Gonnie2219/AI-Anti-Theft-System-CAV/firmware/AntiTheftSystemLilygo.ino

/*
 * Anti-Theft System  -  LILYGO T-SIM7600G-H Cellular Gateway
 *
 * Receives ALERT and STATUS messages from the Main ESP32 over UART2 and
 * POSTs notifications + photo evidence to ntfy.sh for the dashboard.
 * Receives owner commands via MQTT push (with Worker-queue poll as
 * fallback) and forwards them to Main over UART.
 *
 * SIM:  Hologram (AT&T/T-Mobile multi-carrier),  APN "hologram"
 *
 * Network notes:
 *   Hologram assigns IPv4 PDP addresses. We use the modem's built-in
 *   HTTP client (AT+HTTPINIT / AT+HTTPACTION) for ntfy.sh communication.
 *   Owner commands arrive via MQTT push (HiveMQ Cloud, AT+CMQTT) with
 *   HTTPS polling of the Cloudflare Worker command queue as fallback.
 *
 * UART map:
 *   Serial   (UART0)  =  USB debug
 *   Serial1  (UART1)  =  SIM7600 modem (TX=27, RX=26)
 *   Serial2  (UART2)  =  Main ESP32     (TX=19, RX=21)
 */

#include <Arduino.h>
#include <HardwareSerial.h>
#include <Preferences.h>
#include "secrets.h"

// ── Pins ─────────────────────────────────────────────────────
#define MODEM_TX        27
#define MODEM_RX        26
#define MODEM_PWRKEY     4
#define MODEM_FLIGHT    25
#define LED_PIN         12
#define MAIN_RX         21
#define MAIN_TX         19

// ── Configuration ────────────────────────────────────────────
const char    APN[]            = "hologram";
const char    NTFY_TOPIC[]     = "antitheft-gonnie-2219";

#define IMG_BUF_SIZE        65536      // 64 KB photo buffer
#define HEARTBEAT_MS      300000UL     // 5 minutes
#define GPS_UPDATE_MS     300000UL     // 5 minutes
#define WORKER_CMD_POLL_URL "https://antitheft-whatsapp-bridge.gonnie2219.workers.dev/commands/poll"
// Adaptive command-poll cadence: fast while armed or recently active,
// slow when idle — each poll costs a full TLS handshake (~5 KB) on
// pay-per-MB cellular, so idle polling is the dominant data cost.
#define CMD_POLL_FAST_MS      5000UL   // armed OR recent activity
#define CMD_POLL_SLOW_MS     30000UL   // idle
#define POLL_ACTIVE_WINDOW_MS 600000UL // 10 min "recent activity" window
#define WORKER_INGEST_URL  "https://antitheft-whatsapp-bridge.gonnie2219.workers.dev/ingest"

// Keep the modem HTTP(S) service initialized across requests instead of
// HTTPTERM after every one — avoids a full TCP+TLS handshake (~5 KB, 2-4 s)
// per request. Session is termed + re-inited only on error/timeout (one
// retry) or when the URL scheme flips between http (ntfy) and https (Worker).
#define USE_PERSISTENT_HTTP 1

// Shared secret for authenticating with Worker endpoints.
// See secrets.h.example — copy to secrets.h and fill in the real value.
#include "secrets.h"

// ── Aliases ──────────────────────────────────────────────────
#define SerialMon  Serial
#define SerialAT   Serial1
HardwareSerial SerialMain(2);

// ── Globals ──────────────────────────────────────────────────
uint8_t*      imgBuffer     = nullptr;
size_t        imgSize       = 0;
bool          networkReady  = false;
bool          systemArmed   = false;
bool          gpsOn         = false;
String        gpsLat, gpsLon, gpsMapsLink;
unsigned long lastHeartbeat = 0;
unsigned long lastGPS       = 0;

// GPS speed (parsed from +CGPSINFO field 8)
float gpsSpeedKnots = 0.0;
float gpsSpeedMph   = -1.0;  // -1 = no fix / unknown
float gpsSpeedKmh   = 0.0;

// Motion state from Main ESP32
String motionState = "UNKNOWN";
float  accelDelta  = 0.0;
float  gyroMag     = 0.0;
unsigned long lastMotionUpdateMs = 0;

// Status push timing
unsigned long lastStatusPushMs = 0;

// Alarm in progress (synchronous — guards status push from firing during handleAlert)
bool alarmInProgress = false;

// Command polling (Worker KV queue)
Preferences   preferences;
String        lastCmdId;
unsigned long lastCmdPoll   = 0;

// Adaptive poll state — fast within POLL_ACTIVE_WINDOW_MS of boot, last
// received command, last ALERT, or last STATUS change; also while armed.
unsigned long lastActivityMs = 0;
bool          pollFast       = true;

// MQTT URC intercept + connection layer.
String atBuffer;                     // persistent serial accumulator
String mqttPendingCmd;               // single-slot command queue
volatile bool mqttConnected = false;
unsigned long lastMqttReconnectMs = 0;
const unsigned long MQTT_RECONNECT_INTERVAL_MS = 10000;  // 10s backoff
static const char* MQTT_CMD_TOPIC = "cmd/antitheft/commands";

// ─────────────────────────────────────────────────────────────
//  Centralized SerialAT reader — intercepts MQTT URCs
// ─────────────────────────────────────────────────────────────
// Reads all available bytes from SerialAT.  Any MQTT RX block or
// +CMQTTCONNLOST URCs are extracted and handled; everything else
// is appended to the global `atBuffer` for the caller to consume.
// When no MQTT URCs are present this is byte-for-byte equivalent
// to the old `while (SerialAT.available()) acc += (char)SerialAT.read()`.
//
// Partial-URC safety: if a +CMQTTRXSTART is detected but +CMQTTRXEND
// has not yet arrived, everything from the marker onward is held
// back in atBuffer.  Only the bytes BEFORE the marker are returned
// to the caller, so HTTP pattern-matchers never see URC fragments.
void drainSerialAT() {
  while (SerialAT.available()) atBuffer += (char)SerialAT.read();

  // ── Cap atBuffer to prevent unbounded growth / heap fragmentation ──
  int bufLen = atBuffer.length();
  if (bufLen > 16384) {
    Serial.println("[MQTT] RX buffer overflow, dropped");
    atBuffer = "";
    return;
  }
  if (bufLen > 8192 && atBuffer.indexOf("+CMQTTRXSTART:") < 0) {
    atBuffer = "";
    return;
  }

  // ── Multi-line MQTT RX block ──────────────────────────────
  //
  // +CMQTTRXSTART: <client>,<topic_total_len>,<payload_total_len>\r\n
  // +CMQTTRXTOPIC: <client>,<sub_len>\r\n<topic_bytes>\r\n
  //   (may repeat; sub-lengths sum to topic_total_len)
  // +CMQTTRXPAYLOAD: <client>,<sub_len>\r\n<payload_bytes>\r\n
  //   (may repeat; sub-lengths sum to payload_total_len)
  // +CMQTTRXEND: <client>\r\n
  int rxIdx = atBuffer.indexOf("+CMQTTRXSTART:");
  if (rxIdx >= 0) {
    int endIdx = atBuffer.indexOf("+CMQTTRXEND:", rxIdx);
    if (endIdx < 0) {
      // Block incomplete — hold back from rxIdx onward
      atBuffer = atBuffer.substring(0, rxIdx);
      return;
    }
    // Require a PAYLOAD marker between START and END (splice safety)
    int payCheck = atBuffer.indexOf("+CMQTTRXPAYLOAD:", rxIdx);
    if (payCheck < 0 || payCheck >= endIdx) {
      // False match (binary collision) — hold back
      atBuffer = atBuffer.substring(0, rxIdx);
      return;
    }
    // Bound end-line: \n must be within 32 chars of endIdx
    int endLineEnd = atBuffer.indexOf('\n', endIdx);
    if (endLineEnd < 0 || endLineEnd - endIdx > 32) {
      atBuffer = atBuffer.substring(0, rxIdx);
      return;
    }
    endLineEnd++;  // consume the \n

    // Extract the full block for parsing
    String block = atBuffer.substring(rxIdx, endLineEnd);

    // Parse payload by concatenating all +CMQTTRXPAYLOAD chunks
    String payload;
    int searchFrom = 0;
    while (true) {
      int pIdx = block.indexOf("+CMQTTRXPAYLOAD:", searchFrom);
      if (pIdx < 0) break;
      int comma = block.indexOf(',', pIdx + 16);  // skip "+CMQTTRXPAYLOAD:"
      if (comma < 0) break;
      int nlAfterHdr = block.indexOf('\n', comma);
      if (nlAfterHdr < 0) break;
      int subLen = block.substring(comma + 1, nlAfterHdr).toInt();
      int dataStart = nlAfterHdr + 1;  // first byte after \n
      if (dataStart + subLen <= (int)block.length()) {
        payload += block.substring(dataStart, dataStart + subLen);
      }
      searchFrom = dataStart + subLen;
    }

    // Trim trailing \r, \n, and space from assembled payload
    String cleaned = payload;
    while (cleaned.length() > 0) {
      char last = cleaned.charAt(cleaned.length() - 1);
      if (last == '\r' || last == '\n' || last == ' ') cleaned = cleaned.substring(0, cleaned.length() - 1);
      else break;
    }

    mqttPendingCmd = cleaned;

    // Splice the entire block out of atBuffer
    atBuffer = atBuffer.substring(0, rxIdx) + atBuffer.substring(endLineEnd);
    return;
  }

  // ── +CMQTTCONNLOST: <client>,<cause>\r\n ──
  int lostIdx = atBuffer.indexOf("+CMQTTCONNLOST:");
  if (lostIdx >= 0) {
    int lostEnd = atBuffer.indexOf('\n', lostIdx);
    if (lostEnd < 0 || lostEnd - lostIdx > 32) {
      // Line incomplete or false match — hold back
      atBuffer = atBuffer.substring(0, lostIdx);
      return;
    }
    // Full line received — flag disconnect, splice out
    mqttConnected = false;
    lostEnd++;  // consume the \n
    atBuffer = atBuffer.substring(0, lostIdx) + atBuffer.substring(lostEnd);
  }
}

// ─────────────────────────────────────────────────────────────
//  MQTT connect — bring up HiveMQ Cloud via AT+CMQTT*
// ─────────────────────────────────────────────────────────────
// Non-blocking in the sense that it returns cleanly on any
// failure (no halt, no retry loop).  Caller retries via loop().
void connectMQTT() {
  SerialMon.println("[MQTT] === Connecting ===");

  // Defensive teardown — clear stale MQTT state from prior run
  sendAT("AT+CMQTTDISC=0,60", "OK", 5000);
  delay(200); while (SerialAT.available()) SerialAT.read();
  sendAT("AT+CMQTTSTOP", "OK", 3000);
  delay(500); while (SerialAT.available()) SerialAT.read();

  // Start MQTT service
  String r = sendAT("AT+CMQTTSTART", "OK", 5000);
  if (r.indexOf("OK") < 0) {
    SerialMon.println("[MQTT] CMQTTSTART failed: " + r);
    return;
  }

  // Acquire client 0 in SSL mode
  r = sendAT("AT+CMQTTACCQ=0,\"antitheft-lilygo\",1", "OK", 5000);
  if (r.indexOf("OK") < 0) {
    SerialMon.println("[MQTT] CMQTTACCQ failed: " + r);
    sendAT("AT+CMQTTSTOP", "OK", 3000);
    return;
  }

  // Bind to SSL context 0 (already configured in setup)
  r = sendAT("AT+CMQTTSSLCFG=0,0", "OK", 3000);
  if (r.indexOf("OK") < 0) {
    SerialMon.println("[MQTT] CMQTTSSLCFG failed: " + r);
    sendAT("AT+CMQTTREL=0", "OK", 3000);
    sendAT("AT+CMQTTSTOP", "OK", 3000);
    return;
  }

  // Pre-connect check: abort if an alert is pending — don't block the loop
  if (alarmInProgress || SerialMain.available()) {
    SerialMon.println("[MQTT] connect aborted (alert pending)");
    sendAT("AT+CMQTTREL=0", "OK", 3000);
    sendAT("AT+CMQTTSTOP", "OK", 3000);
    return;
  }

  // Connect to broker (8s timeout — keeps worst-case loop stall bounded)
  String connectCmd = "AT+CMQTTCONNECT=0,\"tcp://"
    + String(MQTT_HOST) + ":" + String(MQTT_PORT)
    + "\",60,1,\"" + String(MQTT_USER) + "\",\"" + String(MQTT_PASS) + "\"";
  r = sendAT(connectCmd, "+CMQTTCONNECT: 0,0", 8000);
  if (r.indexOf("+CMQTTCONNECT: 0,0") < 0) {
    SerialMon.println("[MQTT] CONNECT failed: " + r);
    sendAT("AT+CMQTTREL=0", "OK", 3000);
    sendAT("AT+CMQTTSTOP", "OK", 3000);
    return;
  }

  // Subscribe — Form A: AT+CMQTTSUB=0,<len>,1  then > prompt then topic bytes
  int tlen = strlen(MQTT_CMD_TOPIC);
  drainSerialAT(); atBuffer = "";
  SerialAT.print("AT+CMQTTSUB=0,");
  SerialAT.print(tlen);
  SerialAT.print(",1\r\n");

  // Wait for > prompt
  unsigned long t0 = millis();
  bool gotPrompt = false;
  while (millis() - t0 < 5000) {
    while (SerialAT.available()) {
      if (SerialAT.read() == '>') { gotPrompt = true; break; }
    }
    if (gotPrompt) break;
    delay(5);
  }
  if (!gotPrompt) {
    SerialMon.println("[MQTT] SUB no > prompt");
    sendAT("AT+CMQTTDISC=0,60", "OK", 5000);
    sendAT("AT+CMQTTREL=0", "OK", 3000);
    sendAT("AT+CMQTTSTOP", "OK", 3000);
    return;
  }

  // Send topic bytes — NO trailing CRLF
  SerialAT.write((const uint8_t*)MQTT_CMD_TOPIC, tlen);

  // Wait for +CMQTTSUB: 0,0
  String subResp;
  t0 = millis();
  while (millis() - t0 < 10000) {
    while (SerialAT.available()) subResp += (char)SerialAT.read();
    if (subResp.indexOf("+CMQTTSUB: 0,0") >= 0) break;
    delay(10);
  }
  if (subResp.indexOf("+CMQTTSUB: 0,0") < 0) {
    SerialMon.println("[MQTT] SUB failed: " + subResp);
    sendAT("AT+CMQTTDISC=0,60", "OK", 5000);
    sendAT("AT+CMQTTREL=0", "OK", 3000);
    sendAT("AT+CMQTTSTOP", "OK", 3000);
    return;
  }

  // Drain any leftover before returning to normal operation
  delay(200);
  while (SerialAT.available()) SerialAT.read();
  atBuffer = "";

  mqttConnected = true;
  SerialMon.println("[MQTT] Connected + subscribed to " + String(MQTT_CMD_TOPIC));
}

// ─────────────────────────────────────────────────────────────
//  Consume pending MQTT commands (max 3 per call to avoid starving loop)
// ─────────────────────────────────────────────────────────────
void consumeMqttCommand() {
  for (int i = 0; i < 3; i++) {
    if (mqttPendingCmd.length() == 0) return;
    String cmd = mqttPendingCmd;
    mqttPendingCmd = "";  // clear immediately to prevent double-process
    SerialMon.println("[MQTT] dispatch: " + cmd);
    lastActivityMs = millis();  // MQTT command = activity (triggers fast poll)
    handleSMSCommand(cmd);
    // Re-drain in case another URC arrived during handleSMSCommand
    drainSerialAT();
  }
}

// ─────────────────────────────────────────────────────────────
//  AT command helper
// ─────────────────────────────────────────────────────────────
String sendAT(String cmd, String expect, unsigned long timeout) {
  drainSerialAT(); atBuffer = "";     // discard stale data (preserves MQTT intercept)
  SerialAT.println(cmd);
  unsigned long start = millis();
  String resp;
  while (millis() - start < timeout) {
    drainSerialAT(); resp += atBuffer; atBuffer = "";
    if (resp.indexOf(expect) >= 0) break;
    delay(10);
  }
  return resp;
}

// ─────────────────────────────────────────────────────────────
//  Network watchdog — verify registration before HTTP traffic
// ─────────────────────────────────────────────────────────────
// AT+CREG? is a local modem query (no data cost). If registration was
// lost (parking garage, tower handoff), re-attach before the request.
// Called from httpInit(), the single chokepoint for ALL outbound HTTP
// (ntfy posts and Worker poll/ingest alike).
bool ensureNetwork() {
  String r = sendAT("AT+CREG?", "OK", 2000);
  if (r.indexOf(",1") >= 0 || r.indexOf(",5") >= 0) {
    if (!networkReady) {
      networkReady = true;
      SerialMon.println("NETWORK: recovered");
    }
    return true;
  }

  SerialMon.println("[NET] not registered - re-attaching...");
  networkReady = false;
  sendAT("AT+CFUN=1", "OK", 15000);   // no-op if already full-function
  for (int i = 0; i < 10; i++) {
    delay(2000);
    r = sendAT("AT+CREG?", "OK", 2000);
    if (r.indexOf(",1") >= 0 || r.indexOf(",5") >= 0) {
      sendAT("AT+CGATT=1", "OK", 10000);   // packet-switched attach
      sendAT("AT+CGACT=1,1", "OK", 10000); // re-activate PDP context
      networkReady = true;
      SerialMon.println("NETWORK: recovered");
      return true;
    }
  }
  SerialMon.println("[NET] re-attach failed");
  return false;
}

// ─────────────────────────────────────────────────────────────
//  HTTP client  (uses SIM7600 built-in HTTPINIT subsystem)
// ─────────────────────────────────────────────────────────────
//
// The HTTPINIT subsystem is a separate network stack from NETOPEN/
// CIPOPEN. With USE_PERSISTENT_HTTP the service stays initialized across
// requests: HTTPINIT once -> per request HTTPPARA (URL/content/headers) ->
// HTTPDATA -> HTTPACTION -> wait URC. HTTPTERM only runs on error/timeout
// (each request function retries once through a fresh init) or when the
// URL scheme flips http<->https (AT+HTTPSSL must be set before HTTPINIT).
// Note: HTTPPARA values (USERDATA etc.) persist within a session — every
// caller sets its own headers, so stale values are always overwritten.
//
// ntfy.sh requests use HTTP (no TLS). The Worker endpoints (/ingest,
// /commands/poll) use HTTPS — the SSL stack is configured once in
// setup() via AT+CSSLCFG, and httpInit() toggles AT+HTTPSSL per URL.
// Alert content and GPS coordinates sent to ntfy are cleartext.
// Accepted trade-off — the ntfy topic name provides obscurity.

// Persistent session state
static bool httpSessionOpen = false;
static bool httpSessionSsl  = false;

static void httpTerm() {
  sendAT("AT+HTTPTERM", "OK", 1000);
  httpSessionOpen = false;
}

static int waitHttpAction(unsigned long timeout) {
  unsigned long start = millis();
  String acc;
  while (millis() - start < timeout) {
    drainSerialAT(); acc += atBuffer; atBuffer = "";
    int idx = acc.indexOf("+HTTPACTION:");
    if (idx >= 0) {
      int eol = acc.indexOf('\n', idx);
      if (eol > idx) {
        // Format:  +HTTPACTION: <method>,<status>,<datalen>
        String urc = acc.substring(idx, eol);
        int c1 = urc.indexOf(',');
        int c2 = urc.indexOf(',', c1 + 1);
        if (c1 > 0 && c2 > c1) {
          return urc.substring(c1 + 1, c2).toInt();
        }
      }
    }
    delay(20);
  }
  return -1;
}

static bool waitDownloadPrompt(unsigned long timeout) {
  unsigned long start = millis();
  String r;
  while (millis() - start < timeout) {
    drainSerialAT(); r += atBuffer; atBuffer = "";
    if (r.indexOf("DOWNLOAD") >= 0) return true;
    if (r.indexOf("ERROR") >= 0) return false;
    delay(10);
  }
  return false;
}

static bool waitOK(unsigned long timeout) {
  unsigned long start = millis();
  String r;
  while (millis() - start < timeout) {
    drainSerialAT(); r += atBuffer; atBuffer = "";
    if (r.indexOf("OK") >= 0) return true;
    if (r.indexOf("ERROR") >= 0) return false;
    delay(10);
  }
  return false;
}

static bool httpInit(String url, String contentType, String headers) {
  bool wasReady = networkReady;
  if (!ensureNetwork()) {
    if (httpSessionOpen) httpTerm();
    return false;
  }
  // Network was re-attached — any kept-alive session is dead.
  if (!wasReady && httpSessionOpen) httpTerm();

  bool wantSsl = url.startsWith("https");

#if USE_PERSISTENT_HTTP
  // Reuse the open session when the SSL mode matches; AT+HTTPSSL must be
  // set before HTTPINIT, so an http<->https switch forces a fresh init.
  if (httpSessionOpen && wantSsl != httpSessionSsl) httpTerm();

  if (!httpSessionOpen) {
    sendAT("AT+HTTPTERM", "OK", 1000);  // clear any stray service
    while (SerialAT.available()) SerialAT.read();
    sendAT("AT+HTTPSSL=" + String(wantSsl ? 1 : 0), "OK", 2000);
    String initResp = sendAT("AT+HTTPINIT", "OK", 5000);
    if (initResp.indexOf("OK") < 0) {
      SerialMon.println("[HTTP] HTTPINIT failed. Modem said: " + initResp);
      return false;
    }
    httpSessionOpen = true;
    httpSessionSsl  = wantSsl;
  } else {
    while (SerialAT.available()) SerialAT.read();
  }
#else
  if (sendAT("AT+HTTPTERM", "OK", 1000).indexOf("OK") >= 0) {
    // ok, was active, now closed
  }
  while (SerialAT.available()) SerialAT.read();

  // Toggle SSL based on URL scheme
  sendAT("AT+HTTPSSL=" + String(wantSsl ? 1 : 0), "OK", 2000);

  String initResp = sendAT("AT+HTTPINIT", "OK", 5000);
  if (initResp.indexOf("OK") < 0) {
    SerialMon.println("[HTTP] HTTPINIT failed. Modem said: " + initResp);
    return false;
  }
#endif

  sendAT("AT+HTTPPARA=\"URL\",\"" + url + "\"", "OK", 3000);
  sendAT("AT+HTTPPARA=\"CONNECTTO\",30", "OK", 2000);
  sendAT("AT+HTTPPARA=\"RECVTO\",30", "OK", 2000);
  sendAT("AT+HTTPPARA=\"CONTENT\",\"" + contentType + "\"", "OK", 3000);
  if (headers.length() > 0) {
    String esc = headers;
    esc.replace("\"", "\\\"");
    sendAT("AT+HTTPPARA=\"USERDATA\",\"" + esc + "\"", "OK", 3000);
  }
  return true;
}

// Returns HTTP status code (200 = success) or -1 for TCP/connection failure.
// One stale-session retry: a kept-alive session can die server-side; the
// first failure terms the session and the second attempt re-inits it.
int httpPostText(String topic, String headers, String body) {
  SerialMon.println("[HTTP] POST /" + topic + "  (" + String(body.length()) + " bytes)");
  unsigned long t0 = millis();
  int status = -1;

  for (int attempt = 0; attempt < 2 && status < 0; attempt++) {
    if (attempt > 0) SerialMon.println("[HTTP] session reset, retrying");
    if (!httpInit("http://ntfy.sh/" + topic, "text/plain", headers)) { httpTerm(); continue; }

    SerialAT.print("AT+HTTPDATA=");
    SerialAT.print(body.length());
    SerialAT.println(",10000");
    if (!waitDownloadPrompt(3000)) { httpTerm(); continue; }
    SerialAT.print(body);
    if (!waitOK(15000))            { httpTerm(); continue; }

    sendAT("AT+HTTPACTION=1", "OK", 3000);
    status = waitHttpAction(60000);
    if (status < 0) httpTerm();
  }

#if !USE_PERSISTENT_HTTP
  httpTerm();
#endif
  unsigned long ms = millis() - t0;
  if (status < 0)         SerialMon.println("[HTTP] TCP fail (" + String(ms) + " ms)");
  else if (status == 200) SerialMon.println("[HTTP] OK (" + String(ms) + " ms)");
  else                    SerialMon.println("[HTTP] HTTP " + String(status) + " (" + String(ms) + " ms)");
  return status;
}

// Returns HTTP status code (200 = success) or -1 for TCP/connection failure.
int httpPostBinary(String topic, String headers, const uint8_t* data, size_t len) {
  SerialMon.println("[HTTP] POST /" + topic + "  (" + String(len) + " binary bytes)");
  if (len > 100000) { SerialMon.println("[HTTP] body too large"); return -1; }
  unsigned long t0 = millis();
  int status = -1;

  for (int attempt = 0; attempt < 2 && status < 0; attempt++) {
    if (attempt > 0) SerialMon.println("[HTTP] session reset, retrying");
    if (!httpInit("http://ntfy.sh/" + topic, "application/octet-stream", headers)) { httpTerm(); continue; }

    SerialAT.print("AT+HTTPDATA=");
    SerialAT.print(len);
    SerialAT.println(",60000");
    if (!waitDownloadPrompt(3000)) { httpTerm(); continue; }

    size_t sent = 0;
    while (sent < len) {
      size_t chunk = (len - sent > 1024) ? 1024 : (len - sent);
      SerialAT.write(data + sent, chunk);
      sent += chunk;
      delay(10);
    }
    if (!waitOK(30000)) { httpTerm(); continue; }

    sendAT("AT+HTTPACTION=1", "OK", 3000);
    status = waitHttpAction(120000);
    if (status < 0) httpTerm();
  }

#if !USE_PERSISTENT_HTTP
  httpTerm();
#endif
  unsigned long ms = millis() - t0;
  if (status < 0)         SerialMon.println("[HTTP] TCP fail (" + String(ms) + " ms)");
  else if (status == 200) SerialMon.println("[HTTP] OK (" + String(ms) + " ms)");
  else                    SerialMon.println("[HTTP] HTTP " + String(status) + " (" + String(ms) + " ms)");
  return status;
}

// ─────────────────────────────────────────────────────────────
//  Retry wrappers — exponential backoff, skip retry on 4xx
// ─────────────────────────────────────────────────────────────
bool httpPostTextRetry(String topic, String headers, String body) {
  for (int attempt = 0; attempt < 3; attempt++) {
    if (attempt > 0) {
      unsigned long backoff = 2000UL << (attempt - 1);  // 2s, 4s
      SerialMon.println("[HTTP] retry " + String(attempt) + "/2 in " + String(backoff) + "ms");
      delay(backoff);
    }
    int rc = httpPostText(topic, headers, body);
    if (rc == 200) return true;
    if (rc >= 400 && rc < 500) {
      SerialMon.println("[HTTP] 4xx client error, not retrying");
      return false;
    }
  }
  return false;
}

bool httpPostBinaryRetry(String topic, String headers, const uint8_t* data, size_t len) {
  for (int attempt = 0; attempt < 3; attempt++) {
    if (attempt > 0) {
      unsigned long backoff = 2000UL << (attempt - 1);
      SerialMon.println("[HTTP] retry " + String(attempt) + "/2 in " + String(backoff) + "ms");
      delay(backoff);
    }
    int rc = httpPostBinary(topic, headers, data, len);
    if (rc == 200) return true;
    if (rc >= 400 && rc < 500) {
      SerialMon.println("[HTTP] 4xx client error, not retrying");
      return false;
    }
  }
  return false;
}

// ─────────────────────────────────────────────────────────────
//  Direct POST to arbitrary URL (for Worker /ingest fast path)
// ─────────────────────────────────────────────────────────────
int httpPostDirect(const char* url, String body) {
  SerialMon.println("[INGEST] POST (" + String(body.length()) + " bytes)");
  String authHeader = "X-CMD-Secret: " + String(CMD_SECRET);
  unsigned long t0 = millis();
  int status = -1;

  for (int attempt = 0; attempt < 2 && status < 0; attempt++) {
    if (attempt > 0) SerialMon.println("[HTTP] session reset, retrying");
    if (!httpInit(String(url), "text/plain", authHeader)) { httpTerm(); continue; }

    SerialAT.print("AT+HTTPDATA=");
    SerialAT.print(body.length());
    SerialAT.println(",10000");
    if (!waitDownloadPrompt(3000)) { httpTerm(); continue; }
    SerialAT.print(body);
    if (!waitOK(15000))            { httpTerm(); continue; }

    sendAT("AT+HTTPACTION=1", "OK", 3000);
    status = waitHttpAction(30000);
    if (status < 0) httpTerm();
  }

#if !USE_PERSISTENT_HTTP
  httpTerm();
#endif
  unsigned long ms = millis() - t0;
  if (status == 200) SerialMon.println("[INGEST] OK (" + String(ms) + " ms)");
  else               SerialMon.println("[INGEST] failed: " + String(status) + " (" + String(ms) + " ms)");
  return status;
}

// ─────────────────────────────────────────────────────────────
//  JSON helper (no library — simple field extraction)
// ─────────────────────────────────────────────────────────────
String extractJsonString(const String& json, const String& field) {
  String key = "\"" + field + "\":\"";
  int start = json.indexOf(key);
  if (start < 0) return "";
  start += key.length();
  int end = json.indexOf('"', start);
  if (end < 0) return "";
  return json.substring(start, end);
}

// [LAT] Extract a bare numeric JSON value (no quotes), e.g. "readTs":1749...
String extractJsonNumber(const String& json, const String& field) {
  String key = "\"" + field + "\":";
  int start = json.indexOf(key);
  if (start < 0) return "";
  start += key.length();
  // Skip whitespace
  while (start < (int)json.length() && json.charAt(start) == ' ') start++;
  int end = start;
  while (end < (int)json.length() && json.charAt(end) >= '0' && json.charAt(end) <= '9') end++;
  if (end == start) return "";
  return json.substring(start, end);
}

// ─────────────────────────────────────────────────────────────
//  HTTP read body (for GET responses)
// ─────────────────────────────────────────────────────────────
String httpReadBody(int maxLen) {
  String cmd = "AT+HTTPREAD=0," + String(maxLen);
  drainSerialAT(); atBuffer = "";     // discard stale data (preserves MQTT intercept)
  SerialAT.println(cmd);

  unsigned long start = millis();
  String acc;
  while (millis() - start < 10000) {
    drainSerialAT(); acc += atBuffer; atBuffer = "";
    if (acc.indexOf("OK") >= 0 || acc.indexOf("ERROR") >= 0) break;
    delay(20);
  }

  // Parse: +HTTPREAD: <len>\r\n<body>\r\nOK
  int idx = acc.indexOf("+HTTPREAD:");
  if (idx < 0) return "";
  int nl = acc.indexOf('\n', idx);
  if (nl < 0) return "";
  int okIdx = acc.indexOf("\r\nOK", nl);
  if (okIdx < 0) okIdx = acc.indexOf("\nOK", nl);
  if (okIdx < 0) return acc.substring(nl + 1);
  return acc.substring(nl + 1, okIdx);
}

// ─────────────────────────────────────────────────────────────
//  Command polling (SMS / Dashboard → Worker KV queue → here)
// ─────────────────────────────────────────────────────────────
void pollWorkerCommands() {
  // On first boot (lastCmdId=="0"), any commands in the queue are
  // stale leftovers. Skip them and just advance the cursor.
  bool skipExecution = (lastCmdId == "0");
  if (skipExecution) {
    SerialMon.println("[CMD] first boot — seeding cursor");
  }

  String url = String(WORKER_CMD_POLL_URL) + "?since=" + lastCmdId;

  String authHeader = "Authorization: Bearer " + String(DEVICE_POLL_TOKEN);
  unsigned long t0 = millis();
  int status = -1;

  // Force fresh session — persistent reuse causes edge 400 on stale socket
  httpTerm();

  for (int attempt = 0; attempt < 2 && status < 0; attempt++) {
    if (attempt > 0) SerialMon.println("[HTTP] session reset, retrying");
    if (!httpInit(url, "", authHeader)) { httpTerm(); continue; }
    sendAT("AT+HTTPACTION=0", "OK", 3000);  // GET
    status = waitHttpAction(15000);
    if (status < 0) httpTerm();
  }

  if (status != 200) {
#if !USE_PERSISTENT_HTTP
    httpTerm();
#endif
    if (status > 0) SerialMon.println("[CMD] poll HTTP " + String(status));
    return;
  }

  String body = httpReadBody(4096);
#if !USE_PERSISTENT_HTTP
  httpTerm();
#endif
  SerialMon.println("[HTTP] GET poll OK (" + String(millis() - t0) + " ms)");

  if (body.length() == 0) return;

  // Extract latestId (top-level string field in JSON response)
  String newLatestId = extractJsonString(body, "latestId");
  // [LAT] Extract top-level readTs for latency measurement
  String readTsStr = extractJsonNumber(body, "readTs");

  // Parse commands array — find each "command":"VALUE" in the response.
  // Worker returns: {"commands":[{"id":"...","command":"STATUS"},...],"latestId":"..."}
  bool hadCommands = false;
  int searchPos = 0;
  while (true) {
    int cmdStart = body.indexOf("\"command\":\"", searchPos);
    if (cmdStart < 0) break;
    cmdStart += 11;  // skip past "command":"
    int cmdEnd = body.indexOf('"', cmdStart);
    if (cmdEnd < 0) break;

    String cmd = body.substring(cmdStart, cmdEnd);
    cmd.trim();
    cmd.toUpperCase();
    hadCommands = true;

    // [LAT] Extract per-command writeTs and log latency metrics
    {
      // Search forward from cmdStart — writeTs follows "command" in the JSON object
      int wtSearch = body.indexOf("\"writeTs\":", cmdStart);
      String writeTsStr = "";
      if (wtSearch >= 0) writeTsStr = extractJsonNumber(body.substring(wtSearch), "writeTs");
      unsigned long httpMs = millis() - t0;
      String pollWaitMs = "";
      if (writeTsStr.length() > 0 && readTsStr.length() > 0) {
        // Both are epoch-ms strings — subtract as doubles to avoid 32-bit overflow
        double wt = 0, rt = 0;
        for (int i = 0; i < (int)writeTsStr.length(); i++) wt = wt * 10 + (writeTsStr.charAt(i) - '0');
        for (int i = 0; i < (int)readTsStr.length(); i++) rt = rt * 10 + (readTsStr.charAt(i) - '0');
        pollWaitMs = String((long)(rt - wt));
      }
      SerialMon.println("[LAT] cmd=" + cmd +
                         " writeTs=" + writeTsStr +
                         " readTs=" + readTsStr +
                         " pollWaitMs=" + pollWaitMs +
                         " httpMs=" + String(httpMs));
    }

    if (skipExecution) {
      SerialMon.println("[CMD] skipped (first boot): " + cmd);
    } else {
      SerialMon.println("[CMD] worker: " + cmd);
      handleSMSCommand(cmd);
    }

    searchPos = cmdEnd + 1;
  }

  if (hadCommands) lastActivityMs = millis();  // user activity → stay on fast poll

  // Advance cursor — only persist to NVS when commands were actually
  // received.  The Worker returns Date.now() as latestId even for empty
  // queues, which would cause a flash write every poll cycle (every 5s).
  if (newLatestId.length() > 0) {
    lastCmdId = newLatestId;
    if (hadCommands) {
      preferences.putString("lastCmdId", lastCmdId);
    }
  }
}

// ─────────────────────────────────────────────────────────────
//  GPS
// ─────────────────────────────────────────────────────────────
void updateGPS() {
  if (!gpsOn) return;  // GPS engine off; keep last-known lat/lon
  String r = sendAT("AT+CGPSINFO", "OK", 2000);
  SerialMon.println("[GPS] raw: " + r);
  int idx = r.indexOf("+CGPSINFO:");
  if (idx < 0) {
    gpsSpeedMph = -1.0;
    SerialMain.println("GPS_SPEED:" + String(gpsSpeedMph, 1));
    return;
  }
  String info = r.substring(idx + 11);
  info.trim();
  if (info.length() < 10 || info.charAt(0) == ',') {
    gpsSpeedMph = -1.0;
    SerialMain.println("GPS_SPEED:" + String(gpsSpeedMph, 1));
    return;
  }

  int c1 = info.indexOf(',');
  int c2 = info.indexOf(',', c1 + 1);
  int c3 = info.indexOf(',', c2 + 1);
  int c4 = info.indexOf(',', c3 + 1);
  if (c4 < 0) {
    gpsSpeedMph = -1.0;
    SerialMain.println("GPS_SPEED:" + String(gpsSpeedMph, 1));
    return;
  }

  float lat = info.substring(0, 2).toFloat() + info.substring(2, c1).toFloat() / 60.0;
  if (info.substring(c1 + 1, c2) == "S") lat = -lat;
  float lon = info.substring(c2 + 1, c2 + 4).toFloat() + info.substring(c2 + 4, c3).toFloat() / 60.0;
  if (info.substring(c3 + 1, c4) == "W") lon = -lon;

  gpsLat = String(lat, 6);
  gpsLon = String(lon, 6);
  gpsMapsLink = "https://maps.google.com/?q=" + gpsLat + "," + gpsLon;

  // Parse speed (field 7 = speed in knots)
  // +CGPSINFO: <lat>,<N/S>,<lon>,<E/W>,<date>,<UTC>,<alt>,<speed_knots>,<course>
  int c5 = info.indexOf(',', c4 + 1);
  int c6 = (c5 >= 0) ? info.indexOf(',', c5 + 1) : -1;
  int c7 = (c6 >= 0) ? info.indexOf(',', c6 + 1) : -1;
  if (c7 >= 0) {
    int c8 = info.indexOf(',', c7 + 1);
    String speedStr = (c8 >= 0) ? info.substring(c7 + 1, c8) : info.substring(c7 + 1);
    speedStr.trim();
    gpsSpeedKnots = (speedStr.length() > 0) ? speedStr.toFloat() : 0.0;
    gpsSpeedMph = gpsSpeedKnots * 1.15078;
    gpsSpeedKmh = gpsSpeedKnots * 1.852;
  } else {
    gpsSpeedKnots = 0.0;
    gpsSpeedMph = 0.0;
    gpsSpeedKmh = 0.0;
  }

  SerialMon.println("[GPS] speed: " + String(gpsSpeedKnots, 2) + " kn / " +
                    String(gpsSpeedMph, 1) + " mph / " + String(gpsSpeedKmh, 1) + " km/h");
  SerialMain.println("GPS_SPEED:" + String(gpsSpeedMph, 1));
}

// ─────────────────────────────────────────────────────────────
//  Battery (AT+CBC — local query, no data cost)
// ─────────────────────────────────────────────────────────────
// SIM7600 replies "+CBC: 3.912V". Older SIMCom firmwares reply
// "+CBC: <charging>,<percent>,<millivolts>". Handle both, and estimate
// percent from voltage when the modem doesn't report one
// (Li-ion: 3.40 V = 0 %, 4.20 V = 100 %, linear).
String getBatteryStatus() {
  String r = sendAT("AT+CBC", "OK", 2000);
  int i = r.indexOf("+CBC:");
  if (i < 0) return "";
  int eol = r.indexOf('\n', i);
  String line = (eol > i) ? r.substring(i + 5, eol) : r.substring(i + 5);
  line.trim();

  float volts = -1.0;
  int   pct   = -1;
  int c1 = line.indexOf(',');
  if (c1 >= 0) {
    int c2 = line.indexOf(',', c1 + 1);
    pct = line.substring(c1 + 1, (c2 > 0) ? c2 : (int)line.length()).toInt();
    if (c2 > 0) volts = line.substring(c2 + 1).toFloat() / 1000.0;
  } else {
    line.replace("V", "");
    volts = line.toFloat();
  }

  if (pct < 0 && volts > 0) {
    pct = (int)((volts - 3.40) / 0.80 * 100.0);
    if (pct < 0)   pct = 0;
    if (pct > 100) pct = 100;
  }
  if (pct < 0 && volts <= 0) return "";

  String s = "Battery: " + String(pct) + "%";
  if (volts > 0) s += " (" + String(volts, 2) + "V)";
  return s;
}

String getModemTime() {
  String r = sendAT("AT+CCLK?", "OK", 2000);
  int i = r.indexOf("+CCLK: \"");
  if (i < 0) return "";
  int j = r.indexOf("\"", i + 8);
  if (j <= i) return "";
  return r.substring(i + 8, j);
}

// ─────────────────────────────────────────────────────────────
//  SMS — inbound
// ─────────────────────────────────────────────────────────────
void handleSMSCommand(String cmd) {
  cmd.trim();
  cmd.toUpperCase();
  SerialMon.println("[CMD] " + cmd);

  if (cmd == "ARM") {
    SerialMon.println("[LAT] uart_relay cmd=ARM t=" + String(millis()));
    SerialMain.println("SMS_CMD:ARM");
  } else if (cmd == "DISARM") {
    SerialMon.println("[LAT] uart_relay cmd=DISARM t=" + String(millis()));
    SerialMain.println("SMS_CMD:DISARM");
  } else if (cmd == "STATUS") {
    SerialMon.println("[LAT] uart_relay cmd=STATUS t=" + String(millis()));
    SerialMain.println("SMS_CMD:STATUS");
  } else if (cmd == "PHOTO") {
    SerialMon.println("[LAT] uart_relay cmd=PHOTO t=" + String(millis()));
    SerialMain.println("SMS_CMD:PHOTO");
  } else if (cmd == "IMMOBILIZE") {
    SerialMon.println("[LAT] uart_relay cmd=IMMOBILIZE t=" + String(millis()));
    SerialMain.println("SMS_CMD:IMMOBILIZE");
  } else if (cmd == "RESTORE") {
    SerialMon.println("[LAT] uart_relay cmd=RESTORE t=" + String(millis()));
    SerialMain.println("SMS_CMD:RESTORE");
  } else if (cmd == "GPS") {
    updateGPS();
    String gpsReply = gpsLat.length() > 0
      ? ("SMS_REPLY: GPS: " + gpsLat + "," + gpsLon + " " + gpsMapsLink)
      : "SMS_REPLY: GPS: no fix";
    httpPostText(NTFY_TOPIC, "Title: Command Reply\r\nPriority: default\r\nTags: speech_balloon", gpsReply);
  } else if (cmd == "HELP") {
    httpPostText(NTFY_TOPIC, "Title: Command Reply\r\nPriority: default\r\nTags: speech_balloon",
                 "SMS_REPLY: Commands: ARM DISARM STATUS PHOTO GPS IMMOBILIZE RESTORE HELP");
  }
  // Unknown commands silently dropped (Worker already validated)
}

// ─────────────────────────────────────────────────────────────
//  Photo reception from Main ESP32
// ─────────────────────────────────────────────────────────────
bool receiveImage() {
  imgSize = 0;
  unsigned long timeout = millis() + 30000;

  while (millis() < timeout) {
    if (!SerialMain.available()) { delay(10); continue; }

    String line = SerialMain.readStringUntil('\n');
    line.trim();
    if (line == "NOIMG") return false;
    if (!line.startsWith("IMG:")) continue;

    size_t expected = line.substring(4).toInt();
    if (expected == 0 || expected > IMG_BUF_SIZE || !imgBuffer) return false;

    SerialMon.println("[IMG] expecting " + String(expected) + " bytes");
    unsigned long byteTimeout = millis() + 20000;
    while (imgSize < expected && millis() < byteTimeout) {
      size_t avail = SerialMain.available();
      if (avail > 0) {
        size_t toRead = expected - imgSize;
        if (avail < toRead) toRead = avail;
        SerialMain.readBytes(imgBuffer + imgSize, toRead);
        imgSize += toRead;
      }
    }

    delay(100);
    while (SerialMain.available()) SerialMain.readStringUntil('\n');  // drain IMG_END

    SerialMon.println("[IMG] got " + String(imgSize) + "/" + String(expected));
    return (imgSize == expected);
  }
  return false;
}

// ─────────────────────────────────────────────────────────────
//  Notifications
// ─────────────────────────────────────────────────────────────
void handleAlert(String reason) {
  alarmInProgress = true;
  bool isPhotoRequest = (reason == "Photo Requested");
  if (!isPhotoRequest) systemArmed = true;  // an alarm can only fire while armed
  lastActivityMs = millis();
  SerialMon.println(isPhotoRequest ? "\n[PHOTO_REQ]" : "\n[ALERT] " + reason);
  digitalWrite(LED_PIN, HIGH);

  // 1) Receive image from Main if it sends one. Must come FIRST so that
  //    Serial2 RX buffer doesn't overflow during multi-second AT operations.
  bool hasImage = receiveImage();

  // 2) Ensure GPS is on — alarm implies system is armed.
  //    Placed AFTER receiveImage() so the modem AT command
  //    can't stall the UART drain during photo transfer.
  if (!gpsOn) {
    String r = sendAT("AT+CGPS=1", "OK", 2000);
    gpsOn = (r.indexOf("OK") >= 0);
    if (gpsOn) SerialMon.println("[GPS] ON (alert)");
  }
  updateGPS();

  // 4) ntfy text notification (real alerts forwarded to WhatsApp by Worker)
  String body, headers;
  if (isPhotoRequest) {
    body = "Photo captured on request";
    headers = "Title: Photo Capture\r\nPriority: low\r\nTags: camera";
  } else {
    body = "ALERT: " + reason;
    headers = "Title: Anti-Theft Alert\r\nPriority: urgent\r\nTags: rotating_light";
    if (gpsMapsLink.length() > 0) headers += "\r\nClick: " + gpsMapsLink;
  }
  String ts = getModemTime();
  if (ts.length() > 0)         body += "\nTime: " + ts;
  if (gpsLat.length() == 0)
    SerialMon.println("[GPS] GPS not yet acquired - sent without location");
  if (gpsLat.length() > 0)     body += "\nLocation: " + gpsLat + "," + gpsLon + "\n" + gpsMapsLink;
  if (gpsSpeedMph >= 0.0)      body += "\nSpeed: " + String(gpsSpeedMph, 1) + " mph";
  if (hasImage)                body += "\nPhoto: https://ntfy.sh/" + String(NTFY_TOPIC);

  bool ntfyOk = httpPostTextRetry(NTFY_TOPIC, headers, body);

  // 4b) Fast path: POST directly to Worker for immediate WhatsApp delivery.
  //     Single attempt, no retry — cron safety net handles failures.
  //     Only for real alerts (photo requests don't need WhatsApp).
  if (!isPhotoRequest) {
    int ingestRc = httpPostDirect(WORKER_INGEST_URL, body);
    SerialMon.println(ingestRc == 200
      ? "[INGEST] Worker accepted"
      : "[INGEST] Worker failed (cron safety net will handle)");
  }

  // 5) ntfy photo (if we have one)
  if (hasImage && imgSize > 0) {
    String imgHdrs = isPhotoRequest
      ? "Title: Requested Photo\r\nFilename: photo.jpg"
      : "Title: Photo Evidence\r\nFilename: alert.jpg";
    httpPostBinaryRetry(NTFY_TOPIC, imgHdrs, imgBuffer, imgSize);
  }

  // 6) Acknowledge to Main
  SerialMain.println(ntfyOk ? "LILYGO_OK: notified" : "LILYGO_ERROR");

  digitalWrite(LED_PIN, LOW);
  SerialMon.println(isPhotoRequest ? "[PHOTO_REQ] complete\n" : "[ALERT] complete\n");
  alarmInProgress = false;
}

void handleStatus(String status) {
  // Only arm/disarm mutate systemArmed — IMMOBILIZED / IGNITION_OK must not clobber it.
  if (status == "ARMED") systemArmed = true;
  else if (status == "DISARMED") systemArmed = false;
  lastActivityMs = millis();
  SerialMon.println("[STATUS] " + status);

  // GPS power: on when armed, off when disarmed.
  // IMMOBILIZED / IGNITION_OK intentionally ignored so GPS
  // stays wherever it was (on if armed → immobilized).
  if (status == "ARMED" && !gpsOn) {
    String r = sendAT("AT+CGPS=1", "OK", 2000);
    gpsOn = (r.indexOf("OK") >= 0);
    SerialMon.println(gpsOn ? "[GPS] ON (armed)" : "[GPS] ON failed");
  } else if (status == "DISARMED" && gpsOn) {
    sendAT("AT+CGPS=0", "OK", 2000);
    gpsOn = false;
    gpsSpeedMph = -1.0;  // speed is meaningless with GPS off
    SerialMon.println("[GPS] OFF (disarmed)");
  }

  String body = "System " + status;
  if (gpsLat.length() > 0) body += "\nLocation: " + gpsLat + "," + gpsLon;
  if (gpsSpeedMph >= 0.0)  body += "\nSpeed: " + String(gpsSpeedMph, 1) + " mph";
  body += "\nMotion: " + motionState;

  String h = "Title: System " + status + "\r\nPriority: low\r\nTags: ";
  h += (status == "ARMED") ? "lock" : "unlock";
  httpPostText(NTFY_TOPIC, h, body);
}

void sendHeartbeat() {
  SerialMon.println("[HEARTBEAT]");
  updateGPS();

  String body = "System online.";
  String ts = getModemTime();
  if (ts.length() > 0)     body += "\nTime: " + ts;
  if (gpsLat.length() > 0) body += "\nLocation: " + gpsLat + "," + gpsLon;
  if (gpsSpeedMph >= 0.0)  body += "\nSpeed: " + String(gpsSpeedMph, 1) + " mph";
  body += "\nMotion: " + motionState;
  String batt = getBatteryStatus();
  if (batt.length() > 0)   body += "\n" + batt;

  httpPostText(NTFY_TOPIC, "Title: Heartbeat\r\nPriority: min\r\nTags: green_circle", body);
}

void sendStatusUpdate() {
  String body = "SPEED:" + String(gpsSpeedMph, 1);
  body += "\nMOTION:" + motionState;
  body += "\nLAT:" + gpsLat;
  body += "\nLON:" + gpsLon;
  String ts = getModemTime();
  if (ts.length() > 0) body += "\nTS:" + ts;

  httpPostText(NTFY_TOPIC, "Title: Status Update\r\nPriority: min\r\nTags: status_update", body);
}

// ─────────────────────────────────────────────────────────────
//  Setup
// ─────────────────────────────────────────────────────────────
void setup() {
  SerialMon.begin(115200);
  delay(1000);
  SerialMon.println("\n=================================");
  SerialMon.println(" Anti-Theft Cellular Gateway");
  SerialMon.println("   APN: " + String(APN));
  SerialMon.println("=================================\n");

  imgBuffer = (uint8_t*)malloc(IMG_BUF_SIZE);
  SerialMon.println(imgBuffer ? "Image buffer OK" : "Image buffer FAIL");

  pinMode(LED_PIN, OUTPUT);
  digitalWrite(LED_PIN, HIGH);

  SerialMain.setRxBufferSize(16384);
  SerialMain.begin(115200, SERIAL_8N1, MAIN_RX, MAIN_TX);
  SerialMon.println("UART2 -> Main ESP32");

  // Power on modem
  pinMode(MODEM_FLIGHT, OUTPUT); digitalWrite(MODEM_FLIGHT, HIGH);
  pinMode(MODEM_PWRKEY, OUTPUT); digitalWrite(MODEM_PWRKEY, HIGH);
  delay(300); digitalWrite(MODEM_PWRKEY, LOW);

  SerialAT.begin(115200, SERIAL_8N1, MODEM_RX, MODEM_TX);
  SerialMon.println("Waiting for modem...");
  delay(6000);

  bool online = false;
  for (int i = 0; i < 10; i++) {
    if (sendAT("AT", "OK", 1000).indexOf("OK") >= 0) { online = true; break; }
    delay(1000);
  }
  if (!online) {
    SerialMon.println("Modem failed to respond");
    SerialMain.println("LILYGO_ERROR");
    return;
  }
  SerialMon.println("Modem online");

  // Echo off (critical: prevents AT+CMGS body from being echoed into the SMS)
  sendAT("ATE0", "OK", 1000);

  // Verbose error reporting — turns generic "ERROR" into "+CME ERROR: <code>"
  // so we can see exactly why the modem refuses a command.
  sendAT("AT+CMEE=2", "OK", 1000);

  // Set APN with IPv4 PDP type. Hologram provides native IPv4.
  // Radio cycle (CFUN=0/1) forces re-attach with the new profile.
  String cfun0 = sendAT("AT+CFUN=0", "OK", 10000);
  if (cfun0.indexOf("OK") < 0) SerialMon.println("[SETUP] CFUN=0 failed: " + cfun0);
  delay(2000);
  String apnR = sendAT("AT+CGDCONT=1,\"IP\",\"" + String(APN) + "\"", "OK", 3000);
  if (apnR.indexOf("OK") < 0) SerialMon.println("[SETUP] APN config failed: " + apnR);
  sendAT("AT+CGAUTH=1,0,\"\",\"\"", "OK", 3000);
  String cfun1 = sendAT("AT+CFUN=1", "OK", 15000);
  if (cfun1.indexOf("OK") < 0) SerialMon.println("[SETUP] CFUN=1 failed: " + cfun1);
  delay(3000);

  // Wait for data registration
  SerialMon.print("Registering");
  for (int i = 0; i < 30; i++) {
    String r = sendAT("AT+CGREG?", "OK", 2000);
    if (r.indexOf(",1") >= 0 || r.indexOf(",5") >= 0) {
      networkReady = true;
      SerialMon.println(" OK");
      break;
    }
    SerialMon.print(".");
    delay(2000);
  }
  if (!networkReady) SerialMon.println(" FAILED");

  // Force packet-switched attach (CGREG=1 only confirms registration,
  // not actual data attach. CGATT=1 is the explicit "give me data" command).
  String cgatt = sendAT("AT+CGATT=1", "OK", 10000);
  if (cgatt.indexOf("OK") < 0) SerialMon.println("[SETUP] PS attach failed: " + cgatt);

  // Activate PDP context (HTTPINIT will use whichever cid is active)
  String cgact = sendAT("AT+CGACT=1,1", "OK", 10000);
  if (cgact.indexOf("OK") < 0) SerialMon.println("[SETUP] PDP activate failed: " + cgact);

  // SSL stack config for HTTPS requests to Cloudflare workers.dev.
  // Must run once before any HTTPINIT call that uses AT+HTTPSSL=1.
  // Context 0 is the default used by the HTTP subsystem.
  SerialMon.println("[SSL] Configuring TLS...");
  String ssl1 = sendAT("AT+CSSLCFG=\"sslversion\",0,4", "OK", 3000);      // TLS 1.2
  String ssl2 = sendAT("AT+CSSLCFG=\"authmode\",0,0", "OK", 3000);        // no cert verify
  String ssl3 = sendAT("AT+CSSLCFG=\"ignorelocaltime\",0,1", "OK", 3000); // ignore RTC drift
  String ssl4 = sendAT("AT+CSSLCFG=\"enableSNI\",0,1", "OK", 3000);       // SNI required for CF
  SerialMon.println("[SSL] sslversion=TLS1.2: " + String(ssl1.indexOf("OK") >= 0 ? "OK" : "FAIL"));
  SerialMon.println("[SSL] authmode=none:     " + String(ssl2.indexOf("OK") >= 0 ? "OK" : "FAIL"));
  SerialMon.println("[SSL] ignorelocaltime:   " + String(ssl3.indexOf("OK") >= 0 ? "OK" : "FAIL"));
  SerialMon.println("[SSL] enableSNI:         " + String(ssl4.indexOf("OK") >= 0 ? "OK" : "FAIL"));

  // Log diagnostic info: PDP profile, addresses (v4 and v6 if dual-stack
  // worked), full context profile with DNS. Together these tell us
  // whether the bearer is actually up and what the network gave us.
  String csq      = sendAT("AT+CSQ",         "OK", 2000);
  String cgattQuery = sendAT("AT+CGATT?",     "OK", 2000);
  String cgdcont  = sendAT("AT+CGDCONT?",    "OK", 2000);
  String cgaddr   = sendAT("AT+CGPADDR=1",   "OK", 2000);
  String contrdp  = sendAT("AT+CGCONTRDP=1", "OK", 3000);
  SerialMon.println("Signal: "    + csq.substring(csq.indexOf("+CSQ:")));
  SerialMon.println("PS attach: " + cgattQuery.substring(cgattQuery.indexOf("+CGATT:")));
  SerialMon.println("PDP type:   " + cgdcont.substring(cgdcont.indexOf("+CGDCONT:")));
  SerialMon.println("Address:   "  + cgaddr.substring(cgaddr.indexOf("+CGPADDR:")));
  SerialMon.println("Profile:   "  + contrdp.substring(contrdp.indexOf("+CGCONTRDP:")));

  // Extra diagnostics
  String cpsi = sendAT("AT+CPSI?", "OK", 2000);
  String ceer = sendAT("AT+CEER", "OK", 2000);
  SerialMon.println("SysInfo:   " + cpsi.substring(cpsi.indexOf("+CPSI:")));
  SerialMon.println("LastErr:   " + ceer.substring(ceer.indexOf("+CEER:")));

  // MQTT — connect to HiveMQ Cloud for push commands
  connectMQTT();
  lastMqttReconnectMs = millis();

  // GPS starts OFF; enabled on STATUS:ARMED from Main
  SerialMon.println("[GPS] off at boot (disarmed)");

  // NVS — persist last ntfy command ID across reboots
  preferences.begin("antitheft", false);
  lastCmdId = preferences.getString("lastCmdId", "0");
  // Migration: reset obviously invalid cursors.  The Worker now returns
  // ntfy message IDs (alphanumeric), so we only reset empty/"now" values.
  if (lastCmdId.length() == 0 || lastCmdId == "now") {
    lastCmdId = "0";
    preferences.putString("lastCmdId", lastCmdId);
  }
  SerialMon.println("Last cmd ID: " + lastCmdId);

  SerialMon.println("Setup complete\n");
  SerialMain.println("LILYGO_READY");

  // Startup notification
  delay(2000);
  updateGPS();
  String startBody = "System online.";
  String ts = getModemTime();
  if (ts.length() > 0) startBody += "\nTime: " + ts;

  if (networkReady) {
    int rc = httpPostText(NTFY_TOPIC, "Title: Startup\r\nPriority: low\r\nTags: rocket", startBody);
    SerialMon.println(rc == 200 ? "Startup HTTP OK" : "Startup HTTP failed (continuing)");
  }

  digitalWrite(LED_PIN, LOW);
  lastHeartbeat    = millis();
  lastCmdPoll      = millis();
  lastGPS          = millis();
  lastStatusPushMs = millis();
  lastActivityMs   = millis();   // boot counts as activity
  pollFast         = true;
  SerialMon.println("POLL: fast (boot)");
}

// ─────────────────────────────────────────────────────────────
//  Main loop
// ─────────────────────────────────────────────────────────────
void loop() {
  unsigned long now = millis();

  // ── MQTT idle drain + consume (skip during alert/photo to avoid byte theft) ──
  if (!alarmInProgress) {
    drainSerialAT();
    consumeMqttCommand();

    // Non-blocking reconnect with backoff
    if (!mqttConnected
        && !SerialMain.available()
        && (now - lastMqttReconnectMs > MQTT_RECONNECT_INTERVAL_MS)) {
      SerialMon.println("[MQTT] reconnecting...");
      connectMQTT();
      lastMqttReconnectMs = millis();
      now = millis();
    }
  }

  // Command poll FIRST — highest priority, latency-sensitive
  bool wantFast = systemArmed || (now - lastActivityMs < POLL_ACTIVE_WINDOW_MS);
  if (wantFast != pollFast) {
    pollFast = wantFast;
    if (pollFast) SerialMon.println(systemArmed ? "POLL: fast (armed)" : "POLL: fast (recent activity)");
    else          SerialMon.println("POLL: slow (idle)");
  }
  if (now - lastCmdPoll > (pollFast ? CMD_POLL_FAST_MS : CMD_POLL_SLOW_MS)) {
    pollWorkerCommands();
    lastCmdPoll = now;
    now = millis();  // refresh after blocking call
  }

  // 1) Commands from Main ESP32
  if (SerialMain.available()) {
    String cmd = SerialMain.readStringUntil('\n');
    cmd.trim();
    if      (cmd.startsWith("ALERT:"))      handleAlert(cmd.substring(6));
    else if (cmd.startsWith("STATUS:"))     handleStatus(cmd.substring(7));
    else if (cmd.startsWith("SMS_REPLY:")) {
      String reply = cmd.substring(10);
      SerialMon.println("[REPLY] " + reply);
      httpPostText(NTFY_TOPIC, "Title: Command Reply\r\nPriority: default\r\nTags: speech_balloon", "SMS_REPLY: " + reply);
    }
    else if (cmd.startsWith("MOTION:")) {
      // Parse "MOTION:<state>,A:<f>,G:<f>"
      String payload = cmd.substring(7);
      int aIdx = payload.indexOf(",A:");
      int gIdx = payload.indexOf(",G:");
      String prevMotion = motionState;
      if (aIdx >= 0) motionState = payload.substring(0, aIdx);
      if (aIdx >= 0 && gIdx > aIdx) accelDelta = payload.substring(aIdx + 3, gIdx).toFloat();
      if (gIdx >= 0) gyroMag = payload.substring(gIdx + 3).toFloat();
      lastMotionUpdateMs = millis();
      SerialMon.println("[MOTION] " + motionState + " A:" + String(accelDelta, 2) + " G:" + String(gyroMag, 2));
      // Immediate status push on state transition (skip initial UNKNOWN)
      if (motionState != prevMotion && prevMotion != "UNKNOWN") {
        sendStatusUpdate();
        lastStatusPushMs = millis();
      }
    }
    else if (cmd.startsWith("IMMOBILIZE_REJECTED:")) {
      SerialMon.println("[SAFETY] " + cmd);
      String ts = getModemTime();
      String body = "Immobilize refused \xe2\x80\x94 vehicle is in motion.";
      body += "\nSpeed: " + String(gpsSpeedMph, 1) + " mph";
      body += "\nMotion: " + motionState;
      body += "\nAccelDelta: " + String(accelDelta, 2) + " m/s^2";
      body += "\nGyroMag: " + String(gyroMag, 2) + " rad/s";
      if (ts.length() > 0) body += "\nTime: " + ts;
      httpPostTextRetry(NTFY_TOPIC, "Title: Safety Lockout\r\nPriority: high\r\nTags: warning", body);
    }
  }

  // 5) Periodic GPS update
  if (now - lastGPS > GPS_UPDATE_MS) {
    updateGPS();
    lastGPS = now;
  }

  // 6) Periodic heartbeat
  if (now - lastHeartbeat > HEARTBEAT_MS) {
    sendHeartbeat();
    lastHeartbeat = now;
  }

  // 7) Periodic status update
  if (!alarmInProgress) {
    unsigned long statusInterval = (motionState == "MOVING") ? 30000UL : 120000UL;
    if (now - lastStatusPushMs >= statusInterval) {
      sendStatusUpdate();
      lastStatusPushMs = now;
    }
  }

  delay(50);
}
