Gonnie2219/AI-Anti-Theft-System-CAV/(commit log)

2026-04-05 Initial release: AI Anti-Theft System for Connected and Autonomous Vehicles
    Three-board ESP32 anti-theft system (Main ESP32 + ESP32-CAM + LILYGO T-SIM7600G-H)
    that detects unauthorized vehicle access, captures photo evidence, and sends
    real-time alerts with GPS location over cellular via ntfy.sh.
    Wayne State University UROP Winter 2026.
2026-04-05 Increase battery recovery delay in sendWithImage() from 1.5s to 5s
    The 18650 battery needs more recovery time after the modem's sustained
    transmission before starting the image upload.
2026-04-06 Use Hologram REST API for SMS, drop broken CMGS path
    [AntiTheftSystemLilygo.ino]
2026-04-06 Clean up firmware: drop SMS code and polish serial output
    Remove all dead SMS code paths from the LILYGO firmware (Hologram REST
    API, AT+CMGS, Hologram device ID, owner phone, API key) since none of
    them delivered messages on this account. The working ntfy.sh transport
    is now the single notification path. Also drop Phase 4b references and
    unify serial monitor output across all three boards for a cleaner
    production look. Update ARCHITECTURE.md to reflect the single-path
    transport.
2026-04-06 Wait for CAM_READY and LILYGO_READY at boot before arming
    Main ESP32 now drains Serial2 and SerialLilyGO at the end of setup()
    until both peripherals report ready, or until a hard 25s timeout elapses.
    Previously, "System ready - DISARMED" printed immediately after UART
    init, so a user who armed and tripped a sensor during the first ~16s
    (LILYGO's modem registration window) would get a text-only ntfy alert
    with no photo: the CAM hadn't finished its own setup, and the ALERT
    line to LILYGO was sitting in LILYGO's UART buffer while its setup
    was still running.
    The readiness wait prints each incoming line from both peripherals
    (so CAM_ERROR:/LILYGO progress is visible during boot) and falls
    thro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
2026-04-13 Add LILYGO 18650 battery level monitoring
2026-04-13 Add debug prints to getBatteryLevel() for AT+CBC troubleshooting
2026-04-13 Fix AT+CBC parser for SIM7600 non-standard voltage format
    [AntiTheftSystemLilygo.ino]
2026-04-14 Dashboard UX redesign: lightbox, markdown, animations, and layout polish
    - Widen dashboard (800px), enlarge map (400px) and feed (600px)
    - Add photo lightbox overlay with click-to-zoom and download button
    - Add formatBody() for bold markdown, clickable links, and GPS coord links
    - Slide-in animation on feed items, blue border for GPS notifications
    - Button icons (shield, unlock, pin, camera) and mobile responsive tweaks
    - Add favicon, AI photo analysis endpoint, and Anthropic SDK dependency
2026-04-14 Update docs: add webapp/AI features, remove incorrect GPIO25 dead pin note
2026-04-20 Include photo in WhatsApp alert via Twilio MediaUrl
    Correlate ntfy photo messages with alerts by time proximity (30s window)
    and attach the image inline using Twilio's MediaUrl parameter.
2026-05-01 Add native SMS channel: outbound alerts + inbound ARM/DISARM/STATUS/PHOTO/GPS/HELP commands
2026-05-01 Add SIM7600 HTTP helpers, fix PDP to IPV4V6, migrate heartbeat
    Replace raw TCP CIPOPEN stack with SIM7600 built-in HTTP service
    (AT+HTTPINIT/HTTPPARA/HTTPDATA/HTTPACTION) to support IPv6-only
    Speedtalk PDP context. Add sendHttpText(), sendHttpBinary(), and
    sendHttpGet() helpers. Remove AT+NETOPEN (only needed for CIPOPEN).
    Migrate sendHeartbeat() as first caller.
    [AntiTheftSystemLilygo.ino]
2026-05-01 Migrate photo PUT upload to sendHttpBinary()
    Replace manual 1KB CIPSEND chunking loop in sendWithImage() with
    sendHttpBinary() which uses AT+HTTPDATA to buffer the entire image
    in modem RAM before sending via AT+HTTPACTION=4 (PUT).
    [AntiTheftSystemLilygo.ino]
2026-05-01 Migrate pollCommands() to sendHttpGet()
    Replace raw TCP GET (tcpConnect/cipSend/manual read/CIPCLOSE) with
    sendHttpGet() which returns a clean response body without HTTP
    headers mixed in.
    [AntiTheftSystemLilygo.ino]
2026-05-01 Remove dead TCP helpers, update docs for HTTP stack migration
    Delete tcpConnect(), cipSend(), waitForResponse(), and NTFY_IP
    constant — all callers now use the SIM7600 HTTP helpers. Update
    ARCHITECTURE.md, docs/ARCHITECTURE.md, and README.md to reflect
    HTTP stack, fix heartbeat interval (2min not 6hr), remove stale
    DNS known issue, note HTTPS is now possible via HTTP stack.
    [AntiTheftSystemLilygo.ino]
2026-05-03 SpeedTalk SMS rewrite + fix 3 bugs from code review
    Enable bidirectional SMS on SpeedTalk SIM (sendSMS, sendAlertSMS,
    checkSMSNotifications, checkUnreadSMS), extend boot wait to 60s,
    relax photo timeout to 15s, remove destructive UART drain.
    Bugfixes from full code review:
    - Reorder alarm handler: receiveImage() before sendAlertSMS() to
    prevent Serial2 RX buffer overflow (50KB photo vs 16KB buffer)
    - Restore networkReady=true on ensureNetwork() early return so HTTP
    calls resume after modem auto-recovery
    - Restore "Photo Requested" guard in sendAlertSMS() to prevent
    sending 3 SMS instead of 2 on PHOTO command
    [AntiTheftSystemLilygo.ino, AntiTheftSystemMainESP.ino]
2026-05-06 Fix May 1 regression: webapp commands + WhatsApp forwarding
    - LILYGO B1: lastCmdId default 'now' -> '0' (ntfy poll=1 needs
    numeric since cursor)
    - LILYGO B2: log raw AT+CGPSINFO + warn on empty gpsLat in alerts
    - LILYGO B3: check AT+CGPS=1 response at boot
    - Worker: filter ntfy messages by body content not title
    (SIM7600 AT+HTTPINIT strips custom HTTP headers)
    - Worker: advance last_poll_timestamp every cron tick with
    5-min freshness guard to prevent backlog floods
    - Worker: regex updates for plain ALERT body and bare URL
    - Webapp: case-insensitive email trigger title match (defensive)
    Verified E2E: WhatsApp delivers reason, GPS, Maps link, AI label,
    and photo on alarm trigger. Worker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
    [AntiTheftSystemLilygo.ino]
2026-05-06 Fix webapp banner state and AI badge trigger
    - H1: ARMED/DISARMED banner reads body.indexOf instead of
    title.indexOf (title is undefined because SIM7600 strips
    custom HTTP headers). DISARMED checked first to avoid
    false ARMED match on 'System DISARMED' substring.
    - H2: AI analyzePhoto trigger uses attachment extension
    match (/\.jpe?g$/i) instead of exact 'alert.jpg' name
    or stripped 'Photo Evidence' title. Mirrors the worker's
    photo detection logic.
    Verified E2E: trigger reed switch -> photo arrives in
    dashboard -> AI badge renders below photo within ~10s.
    Banner flips immediately on Arm/Disarm via SSE.
2026-05-06 Fix B4: separate photo requests from intrusion alerts
    User-initiated PHOTO commands now post to ntfy with:
    - Body prefix "Photo captured on request" (not "ALERT:")
    - Title "Photo Capture", Priority low, Tag camera
    - Filename "photo.jpg" (not "alert.jpg")
    This prevents the Worker from forwarding requested photos to WhatsApp
    as urgent alerts, and prevents the dashboard from sending email for
    them. Real intrusion alerts are unchanged.
    [AntiTheftSystemLilygo.ino]
2026-05-06 Fix B5: check xTaskCreatePinnedToCore return value
    If the alarm task fails to launch (e.g. heap exhaustion), free the
    strdup'd reason string and reset alarmInProgress so future alarms
    aren't permanently blocked.
    [AntiTheftSystemMainESP.ino]
2026-05-06 Fix S1: retry with exponential backoff on failed ntfy POST
    httpPostText/httpPostBinary now return int (HTTP status or -1 for
    TCP/connection failure) instead of bool. Added httpPostTextRetry and
    httpPostBinaryRetry wrappers with:
    - Up to 3 attempts (2s, 4s exponential backoff)
    - No retry on 4xx client errors (won't succeed)
    - Retry on TCP failure (-1) and 5xx server errors
    handleAlert uses the retry wrappers for both text and photo POSTs.
    Other call sites (heartbeat, status, startup) use the base functions.
    [AntiTheftSystemLilygo.ino]
2026-05-06 Fix S3: log failures on APN config and PDP activation
    AT commands for CFUN=0/1, CGDCONT (APN), CGATT (PS attach), and
    CGACT (PDP activate) now check return values and log specific
    failure messages. Failures are non-fatal (network registration loop
    is the real gate) but now visible in serial monitor for debugging.
    [AntiTheftSystemLilygo.ino]
2026-05-06 Fix R1: dedup SSE messages by ID on reconnect
    Track seen ntfy message IDs in a Set. On SSE reconnect, replayed
    messages are silently dropped. Set is capped at 200 entries (evicts
    oldest 100 when full) to bound memory.
2026-05-06 Fix B1: XSS in photo download button onclick handler
    Replaced inline onclick with data-url attribute + addEventListener.
    The old inline handler used single-quoted JS string which didn't
    escape single quotes in URLs, allowing script injection via crafted
    ntfy attachment URLs.
2026-05-06 Fix B6/D3: remove dead REMOTE_ARM/REMOTE_DISARM handlers
    LILYGO never sends REMOTE_ARM or REMOTE_DISARM to Main — it sends
    SMS_CMD:ARM / SMS_CMD:DISARM instead (handled on line 177). These
    branches were unreachable dead code.
    [AntiTheftSystemMainESP.ino]
2026-05-06 X1: document HTTP-not-HTTPS trade-off in LILYGO
    SIM7600 HTTPSSL fails TLS handshakes with ntfy.sh in practice.
    Added comment so future audits skip this known limitation.
    [AntiTheftSystemLilygo.ino]
2026-05-06 D1: remove battery widget from dashboard
    No firmware component sends battery data, so the widget permanently
    showed "--". Removed HTML, CSS, and JS (localStorage restore, update
    on message). Cleaner than a dead widget.
2026-05-06 Fix S3 compile error: rename shadowed cgatt variable
    Line 746 redeclared `String cgatt` (diagnostic query) which shadowed
    the `String cgatt` on line 735 (AT+CGATT=1 result). Renamed to
    cgattQuery. Confirmed clean compile (esp32:esp32:esp32wrover).
    [AntiTheftSystemLilygo.ino]
2026-05-06 Phase 2a: drop LILYGO command poll from 15s to 5s
    Reduces ARM/DISARM tap-to-action latency from ~15s worst case to ~5s.
    Dedup is rate-independent (ntfy since=lastCmdId returns only newer
    messages). Added Serial.println of poll cadence for monitor visibility.
    Hologram data headroom is fine — each poll is a ~200-byte GET.
2026-05-06 Phase 2c: optimistic UI on all four command buttons
    Tap behavior:
    - Button immediately shows spinner + "Arming…" / "Disarming…" etc.
    - ARM/DISARM: status pill flips to expected new state instantly
    - When real SSE update arrives, status confirms with a brief pulse
    - If no confirmation within 20s, button shows "No response in 20s —
    tap to retry" with red outline; status pill reverts
    - If ntfy POST itself fails, immediately shows "Send failed" retry
    Only one command can be pending at a time. GPS confirms on Location
    response, PHOTO confirms on photo attachment or "Photo" in body.
2026-05-06 Phase 2d: heartbeat every 5min, online threshold 15min
    LILYGO heartbeat dropped from 6 hours to 5 minutes. Dashboard offline
    rule changed from "no message in 3 min" to "no message in 15 min"
    (3x the heartbeat interval for margin).
    The SYSTEM OFFLINE banner will no longer appear during normal idle
    periods. Each heartbeat includes GPS + timestamp, which also keeps
    the dashboard map and "last seen" timer fresh.
    Hologram data impact: ~288 heartbeats/day × ~200 bytes = ~56 KB/day.
    [AntiTheftSystemLilygo.ino]
2026-05-06 Phase 3: dashboard visual redesign
    Compact header with status pill + last-seen timer, hero row
    (dark CARTO map + photo panel with AI badge overlay), grouped
    action bar, compact 10-item event feed with thumbnails.
    Inter font, CSS custom properties, #0ea5e9 accent, GPS
    breadcrumb trail, mobile responsive at 640px/380px.
    All data-layer logic (SSE, optimistic UI, email dedup) preserved.
2026-05-06 Fix ARM/DISARM confirmation: case-insensitive body matching
    The LILYGO sends mixed-case status messages: SMS_REPLY has
    "System armed" (lowercase) while STATUS has "System ARMED"
    (uppercase). The old indexOf checks were case-sensitive, so
    the first SSE message ("System armed") never triggered
    confirmCommand(), leaving the button stuck in pending state
    for the full 20s timeout.
    Now uses body.toLowerCase() before checking for 'armed' /
    'disarmed', matching all variations including "Already armed".
2026-05-06 Fix email alerts: switch to ntfy JSON publish API
    The old approach used custom HTTP headers (Title, Priority, Tags,
    Email) in a plain POST. Since the SIM7600 strips headers, `title`
    arrived as empty string, and the custom `Email` header may have
    been rejected by ntfy's CORS preflight or server-side validation.
    Switched to ntfy's JSON publish API which puts all metadata
    (topic, title, priority, tags, email) in the JSON body. This
    avoids custom-header CORS issues and provides a fallback title
    ("Anti-Theft Alert") when the original is empty. Added
    console.error logging for debugging if email still fails.
2026-05-06 Load event history on page refresh from ntfy poll endpoint
    On dashboard mount, fetches last 24h of messages from
    ntfy.sh/.../json?poll=1&since=24h before opening SSE stream.
    Populates event feed, hero photo panel, GPS map, and status
    pill from historical data. Message IDs are added to seenMsgIds
    so SSE doesn't replay them.
    Historical messages skip email alerts, AI photo analysis, and
    optimistic UI confirmation. Feed timestamps use the original
    message time (msg.time) instead of Date.now(). Hero photo for
    historical images omits the "Analyzing..." AI badge.
    Status pill and lastMessageTime already persist in localStorage
    for immediate first-paint before the fetch completes.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
2026-05-06 Phase 4: Main ESP immobilization relay control
    GPIO22 drives a 5V relay (HIGH-trigger, active-high = ignition
    enabled). State persisted in NVS via Preferences so immobilization
    survives reboot. Default boot state: read from NVS (false = enabled).
    New SMS_CMD handlers: IMMOBILIZE (pin LOW, persist, reply + STATUS)
    and RESTORE (pin HIGH, persist, reply + STATUS). STATUS reply now
    includes ignition state. LILYGO receives STATUS:IMMOBILIZED or
    STATUS:IGNITION_OK and posts to ntfy for dashboard SSE pickup.
    [AntiTheftSystemMainESP.ino]
2026-05-06 Phase 4: LILYGO forwards IMMOBILIZE/RESTORE to Main ESP
    Adds IMMOBILIZE and RESTORE cases to handleSMSCommand() which
    forward SMS_CMD:IMMOBILIZE and SMS_CMD:RESTORE to Main ESP via
    UART. Updates HELP text. Existing STATUS handler already relays
    the Main ESP's STATUS:IMMOBILIZED / STATUS:IGNITION_OK responses
    to ntfy via handleStatus().
2026-05-06 Phase 4: Dashboard immobilization controls
    Adds IGNITION OK / IMMOBILIZED pill in header next to armed status.
    Immobilize and Restore buttons in action bar with two-step confirm
    dialog. Optimistic UI with revert on failure. SSE detection matches
    "immobilized", "ignition restored", "ignition_ok", "ignition: ok"
    (case-insensitive). State persisted in localStorage. History load
    on refresh picks up ignition state from recent ntfy messages.
2026-05-07 Fix: move immobilize relay from GPIO22 to GPIO23
    GPIO22 reads 0V even when set HIGH — likely a pin conflict or
    board-specific mapping issue. GPIO23 is free on this board.
    [AntiTheftSystemMainESP.ino]
2026-05-07 worker: add IMMOBILIZE and RESTORE to valid commands
    The Worker rejected these two commands at the front door because
    VALID_COMMANDS only listed the original six. Now all eight commands
    (ARM, DISARM, STATUS, PHOTO, GPS, HELP, IMMOBILIZE, RESTORE) pass
    validation and get forwarded to the LILYGO via ntfy.
2026-05-07 lilygo: prefix all command replies with SMS_REPLY for Worker pickup
    Three places posted reply text to ntfy without the "SMS_REPLY:" prefix
    that the Worker uses to classify messages as command replies:
    1. GPS handler — built reply as "GPS: lat,lon" (line 528)
    2. HELP handler — built reply as "Commands: ..." (line 533)
    3. loop() UART handler — stripped the prefix from Main ESP's
    SMS_REPLY: line before posting to ntfy (line 884)
    Without the prefix the Worker never matched these as replies, so
    GPS coordinates, HELP menu, and all ARM/DISARM/STATUS/IMMOBILIZE/
    RESTORE confirmations were silently dropped.
    Also changed GPS reply from multi-line (\n) to single-line (space)
    so the entire r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
2026-05-07 lilygo: skip stale commands on first boot to prevent replay
    On first boot lastCmdId is "0", so the ntfy poll with since=0 returns
    up to 12 hours of cached messages. Previously every one of those stale
    commands (ARM, PHOTO, IMMOBILIZE, etc.) would execute immediately,
    potentially arming the system or triggering photo captures.
    Now we detect the sentinel value and set skipExecution=true for the
    first poll cycle. Stale messages are logged but not executed, and the
    cursor advances past them so subsequent polls only see new commands.
    [AntiTheftSystemLilygo.ino]
2026-05-07 worker: wire SMS outbound plumbing (USE_TWILIO_SMS still false pending 10DLC)
    End-to-end SMS delivery path is now wired but gated behind
    USE_TWILIO_SMS = false. Flip to true once the Twilio 10DLC Sole
    Proprietor campaign is approved.
    Changes:
    - /ingest: send SMS immediately alongside WhatsApp; track smsOk in
    dedup so cron retries only what actually failed.
    - cron: pass photo URL to formatSMSMessage so SMS includes a link
    when a photo is available.
    - formatSMSMessage: accept optional photoUrl, single-line output
    capped at 160 chars to avoid multi-segment billing.
    - Reply handler: strip "SMS_REPLY:" prefix before sending as SMS
    so the user sees clean text, not protocol framing.
    - send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
2026-05-07 worker: replace ntfy command topic with KV-backed command queue
    ntfy free tier rate-limits (429) killed the inbound SMS command path.
    Replace ntfy as the command transport with a KV-backed FIFO queue:
    - /sms/inbound: writes command to KV (cmd:<ts>-<rand>) with 5min TTL
    instead of POSTing to ntfy command topic
    - GET /commands/poll?since=<id>: LILYGO polls this for new commands.
    Returns {commands: [{id, command, ts}], latestId} JSON.
    latestId always present so LILYGO can advance cursor even on empty.
    - POST /commands/dispatch: dashboard buttons write to the same KV
    queue. Validates command, returns queued status. CORS enabled.
    - Removed NTFY_CMD_TOPIC constant (no longer used).
    ntfy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
2026-05-07 webapp: route dashboard commands through Worker instead of ntfy
    Dashboard buttons now POST to Worker /commands/dispatch instead of
    ntfy command topic. Same body (plain text command), same optimistic
    UI and 20s timeout logic — only the URL changes.
    Replaced CMD_TOPIC constant with WORKER_URL pointing at the
    Cloudflare Worker origin.
2026-05-07 lilygo: poll Worker KV queue instead of ntfy for commands
    Replace pollNtfyCommands() with pollWorkerCommands() that GETs from
    the Worker /commands/poll endpoint over HTTPS.
    - New URL: WORKER_CMD_POLL_URL (same 5s cadence as before)
    - JSON parser: extracts "command" fields from the commands array
    and "latestId" for cursor advancement (using simple indexOf, no
    JSON library needed)
    - NVS cursor migration: resets legacy ntfy alphanumeric IDs that
    would mis-sort against our timestamp-based IDs
    - First-boot skip preserved: seeds cursor from Worker's latestId
    on initial empty poll (simpler than the ntfy 12h cache case
    since KV commands have 5min TTL)
    - Renamed NTFY_CMD_TOPIC → WORKER_C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
    [AntiTheftSystemLilygo.ino]
2026-05-07 worker: use single-key KV queue to avoid list() consistency lag
    KV list() has up to 60s eventual consistency across edge locations,
    which made the cmd: prefix approach unreliable for 5-second polling.
    Switch to a single KV key "cmd_queue" storing a JSON array. Both
    enqueue (write) and poll (read) operate on the same key, which
    propagates much faster than list() index updates.
    - enqueueCommand(): shared by /sms/inbound and /commands/dispatch.
    Reads queue, prunes entries older than 5 min, appends, writes back.
    - handleCommandsPoll(): reads the single key, filters by since param.
    - Response shape unchanged: {commands: [...], latestId: "..."} so
    the LILYGO parser needs no changes.
    Co-Auth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
2026-05-07 lilygo: configure SIM7600 TLS stack for Cloudflare workers.dev
    AT+HTTPSSL=1 alone uses factory SSL defaults, which fail TLS
    handshake (HTTP 715) against workers.dev. Add one-time CSSLCFG
    setup in setup() after PDP activation:
    - sslversion=4 (TLS 1.2 only)
    - authmode=0 (skip cert verification)
    - ignorelocaltime=1 (tolerate RTC drift)
    - enableSNI=1 (required for Cloudflare tenant routing)
    Each command's result is logged so we can see immediately if the
    modem firmware supports CSSLCFG. If any returns ERROR, we pivot
    to a non-TLS approach.
    [AntiTheftSystemLilygo.ino]
2026-05-07 Fix: avoid unnecessary NVS writes on every command poll cycle
    Worker returns Date.now() as latestId even for empty queues, causing
    a flash write every 5s. Now only persist lastCmdId when commands were
    actually received. Also updated stale HTTP/HTTPS comment.
    [AntiTheftSystemLilygo.ino]
2026-05-07 Add /status endpoint for reliable dashboard state sync
    Worker cron extracts system status from ntfy "System X" messages and
    stores in KV. Dashboard polls GET /status every 15s to correct drift
    from SSE gaps. Fixes status mismatch where dashboard showed ARMED
    while board was DISARMED (or vice versa).
2026-05-07 Reliability: instant command confirm, 5s status poll, reduce modem load
    - Dashboard: state-changing commands (ARM/DISARM/IMMOBILIZE/RESTORE) confirm
    immediately on successful dispatch instead of waiting for unreliable SSE
    - Dashboard: /status poll interval 15s → 5s for faster state correction
    - Worker: SMS inbound gets same optimistic system_status KV update as dashboard
    - Firmware: command poll interval 5s → 10s to reduce SIM7600 TLS overhead
    - Docs: update ARCHITECTURE.md, README.md, worker/README.md for current state
    [AntiTheftSystemLilygo.ino]
2026-05-07 Fix: dual-source command queue (ntfy + KV) for sub-7s dashboard latency
    Dashboard commands were taking 12-40s because Cloudflare KV has up to
    60s cross-edge caching. Worker can't POST to ntfy (shared IPs exhaust
    daily quota). Fix: browser POSTs commands directly to ntfy cmd topic
    (user's IP, no rate limit). Worker /commands/poll reads BOTH ntfy
    (dashboard commands, instant) and KV (SMS commands, same-edge fast),
    returning a composite cursor "ntfyId,kvTimestamp".
    - webapp: parallel POST to ntfy + Worker on every command
    - worker: dual-source poll handler, restored KV enqueue for SMS path
    - firmware: relaxed migration check to accept ntfy alphanumeric IDs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
    [AntiTheftSystemLilygo.ino]
2026-05-10 Security: auth on command pipeline, SSRF fix, alarm-task hardening
    - Worker: add CMD_SECRET auth to /ingest and /commands/dispatch (401 without it)
    - Worker: validate secret prefix on ntfy cmd topic messages (blocks public injection)
    - Worker: timing-safe HMAC comparison in Twilio signature verification
    - Dashboard: derive CMD_SECRET from login credentials, send with all commands
    - LILYGO: send X-CMD-Secret header on /ingest POSTs, secret in gitignored secrets.h
    - Webapp: SSRF protection on /api/analyze — allowlist ntfy.sh hostnames only
    - Main ESP: guard strdup NULL (OOM crash), process SMS_CMD during alarm task
    [AntiTheftSystemLilygo.ino, AntiTheftSystemMainESP.ino]
2026-05-23 Add A2P 10DLC opt-in flow: opt-in, privacy, terms pages + consent API
2026-05-26 fix(webapp): SSE Title dispatch + null-state immobilize block
    - Status Update detection: body content (SPEED: + MOTION:) instead of title
    - Safety Lockout detection: body content (Immobilize refused) instead of title
    - SIM7600 HTTPINIT strips Title/Priority headers, so title-based dispatch never fired
    - Add isSensorBlind guard: null motionState + null speed shows stale-warn button
    and requires explicit confirmation before immobilize
2026-05-27 fix(webapp+worker): SSE reply-gated button state, 60s timeout, KV timestamp diagnostics
    - Replace timer-based GPS/PHOTO button clearing with SSE reply-gated
    state machine; consolidate all command matchers in one block with
    console.log('[CmdClear]') traces for debugging
    - Status-push GPS coords now clear pending GPS command (early-return path)
    - Timeout raised from 30s to 60s to accommodate KV cross-edge cache lag
    - Worker /commands/dispatch returns writeTs, /commands/poll returns readTs
    and per-command writeTs for measuring KV propagation delay
    - Fix stale comment in dispatch handler
2026-06-12 mobile: SDK 55 downgrade + WebView hardening (origin-gated injection, external links to system browser)
    Builds clean; device-untested — Expo Go App Store is stuck on SDK 54, will verify via dev build.
2026-06-12 Add PWA manifest + service worker + Web Push alert channel
    Worker: RFC 8291/8292 Web Push via WebCrypto (VAPID ES256 JWT +
    aes128gcm), /push/subscribe|unsubscribe|test endpoints (CMD_SECRET
    auth), fan-out wired into both /ingest fast path and cron alert loop
    with push dedup flag; dead subscriptions (404/410) pruned from KV.
    Webapp: installable PWA (manifest + icons + apple-touch-icon),
    push-only sw.js (no caching), enable-notifications bell with iOS
    Add-to-Home-Screen hint and test send. ntfy transport unchanged.
2026-06-12 perf(lilygo): adaptive 5/30s command poll, ensureNetwork recovery, AT+CBC battery in heartbeat
    Idle polling at a fixed 5s cost a full TLS handshake (~5KB) per poll on
    pay-per-MB cellular (~100MB/day); now 30s when disarmed and idle for 10min.
    ensureNetwork() re-attaches (CREG/CFUN/CGATT/CGACT) before every HTTP request
    so a dropped registration no longer bricks notifications until reboot.
    Heartbeat now carries "Battery: NN% (V.VVV)" from AT+CBC.
    Both ARCHITECTURE.md copies updated to reality: Hologram APN, KV-only command
    queue (ntfy -cmd topic removed), 5min heartbeat, adaptive poll, Web Push channel.
    [AntiTheftSystemLilygo.ino]
2026-06-12 feat(firmware): NC relay, photo-first alarm + CAM diagnostics/retry, persistent HTTP
    Main ESP32:
    - Relay NC inversion (RELAY_WIRING_NC): coil energized only while
    immobilized (~70 mA saved), fails safe to ignition-OK; NVS state
    re-asserted at boot with glitch-free latch pre-set
    - alarmTask: PHOTO requested before siren so evidence is captured
    before the intruder is warned
    - CAM outcome surfaced in alert body as "Cam: <status>" (PHOTO_OK /
    CAM_NO_RESPONSE / CAM_PARTIAL / CAM_GARBAGE) with one flush+2s retry;
    ALERT now sent after the photo phase so the status rides along
    LILYGO:
    - USE_PERSISTENT_HTTP: HTTP(S) service kept initialized across requests
    (TLS handshake reused); term+re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
    [AntiTheftSystemLilygo.ino, AntiTheftSystemMainESP.ino]
2026-06-13 fix(lilygo): reliable command poll + latency instrumentation
    - Fix stale-socket 400: force fresh HTTP session per command poll
    (persistent reuse on SIM7600G emitted malformed requests rejected
    at Cloudflare edge). Verified via wrangler tail — polls now succeed
    back-to-back.
    - Fix [LAT] writeTs parse (lastIndexOf -> indexOf): writeTs sits after
    "command" in the JSON, so backward search never found it; pollWaitMs
    now computes.
    - Reorder loop(): command poll runs first, before UART/status/heartbeat
    HTTP, so a pending command is never delayed behind a blocking call.
    - Add [LAT] instrumentation (pollWaitMs, httpMs, uart_relay) for
    latency baseline measurement.
    Known limitation: e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
    [AntiTheftSystemLilygo.ino]
2026-06-16 refactor(firmware): centralized drainSerialAT() for MQTT URC intercept
    Behavior-preserving read-path refactor on LILYGO. All 5 SerialAT read functions
    (sendAT, waitHttpAction, waitDownloadPrompt, waitOK, httpReadBody) now route through
    drainSerialAT(), which intercepts +CMQTTRECV/+CMQTTCONNLOST URCs with partial-URC
    hold-back so HTTP pattern-matchers never see URC fragments. mqttPendingCmd/mqttConnected
    globals added but inert (MQTT not yet connected). Verified on hardware: ARM relay, ntfy
    text, Worker /ingest, and binary photo upload all functioning post-refactor. Step 1 of
    MQTT migration.
2026-06-16 fix(ai): update retired Sonnet model + log analyze errors
    claude-sonnet-4-20250514 was retired 2026-06-15, causing /api/analyze to 500 and the
    dashboard to show 'AI unavailable'. Updated model string to claude-sonnet-4-6 (current).
    Also added console.error of err.status/err.message in the catch block so future API
    failures are diagnosable from Vercel logs instead of collapsing into a generic message.
    Verified: curl to production returns HTTP 200 with a real threatLevel classification.
2026-06-16 feat(firmware): MQTT push command reception via SIM7600 multi-line +CMQTTRX parser
    - Rewrite drainSerialAT() for real +CMQTTRXSTART/RXTOPIC/RXPAYLOAD/RXEND framing (replaces nonexistent +CMQTTRECV)
    - Multi-packet payload concat, trailing CR/LF/space trim, bounded splice with payload-marker guard, atBuffer overflow cap
    - connectMQTT(): defensive teardown, TLS ctx 0 reuse, Form A subscribe, 8s connect timeout, alert-preemption
    - consumeMqttCommand(): copy-clear-dispatch via handleSMSCommand, max 3/pass
    - loop wiring gated on !alarmInProgress && !SerialMain.available(); non-blocking reconnect with 10s backoff
    - HTTP command poll retained in parallel as fallback
    Verified on hardware: connect+su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
    [AntiTheftSystemLilygo.ino]
2026-06-16 fix(dashboard): confirm ARM/DISARM from SSE state message (~2s vs ~45s KV lag)
    Match authoritative "System ARMED"/"System DISARMED" via startsWith
    instead of waiting for KV poll. Rejects SMS_REPLY echoes. KV poll
    remains as fallback for missed SSE / page load.
2026-06-16 fix(dashboard): eliminate all confident-wrong-state paths + fast IMMOBILIZE/RESTORE confirm
    1. Always-on live SSE reconcile: authoritative "System X" messages update
    pill unconditionally (not gated on pendingCmd), handling late arrivals,
    unsolicited changes, and SSE reconnect races.
    2. staleGuardTs: after timeout, KV poll blocked until KV timestamp proves
    freshness — prevents stale KV from asserting wrong state.
    3. Timeout clears lastKnownStatus/lastIgnitionState + localStorage so SSE
    reconnect can't reassert stale state.
    4. Remove unconditional indexOf ignition matching (fired on SMS_REPLY
    echoes and history replay) — replaced by prefix-matched live reconcile.
    5. IMMOBILI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
2026-06-17 fix(dashboard): single-writer pill state machine — kill 4 racing-writer bugs at root
    Replace 5-writer/12-call-site racing pill logic with single-writer state machine (pillState + renderPills + applyObservation). Fixes disarm-flips-back, no-response-on-ARM, immobilize/restore flip-flop, stale-on-load. Removes staleGuardTs, optimistic ignition writes, confident localStorage init, SSE-onopen reassert, unguarded KV overwrite. Contract in docs/PILL_STATE_SPEC.md. Correctness fix — confirmation stays SSE-bound. NOT hardware-verified yet.
2026-06-17 fix(dashboard): 120s button timeout for IMMOBILIZE/RESTORE — stop false 'No response' on slow ignition round-trip
2026-06-18 Fix CAM photo path: single-frame capture + RX-safe handoff
    Resolves the double-burst and the photo never landing end-to-end.
    - Main: IMG_BUF_SIZE 51200 -> 65536 so a normal VGA q12 JPEG (25-40 KB)
    is no longer false-rejected as CAM_GARBAGE (the false reject was firing
    the retry, which sent a 2nd PHOTO mid-stream -> phantom 2nd burst).
    - Main: split genuine receive timeout (CAM_TIMEOUT) from oversized/corrupt
    (CAM_GARBAGE) so a real failure is diagnosable; retry only on true timeout.
    - Main: move the PHOTO request to immediately before receivePhotoFromCAM()
    (was ~1050 ms earlier, before the buzzer). The faster single-keeper CAM
    streams the body ~600 ms after PHOTO; the Main must al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
    [AntiTheftSystemESP32CAM.ino, AntiTheftSystemMainESP.ino]
2026-06-23 feat(firmware/Main): LED blink + event-driven motion push
    - Status LEDs blink (50ms on / 2s period) instead of solid — cuts
    LED current from continuous to 2.5% duty cycle.
    - Motion state transitions (STATIONARY↔MOVING) now trigger an
    immediate UART push to LILYGO instead of waiting for the periodic
    5s/30s poll interval.
    - Blink timer resets on arm/disarm so the state change is visually
    confirmed before blinking resumes.
    [AntiTheftSystemMainESP.ino]
2026-06-23 feat(firmware/LILYGO): GPS gated on armed state + event-driven motion status
    - GPS engine (AT+CGPS) starts OFF at boot; enabled on STATUS:ARMED,
    disabled on STATUS:DISARMED. IMMOBILIZED/IGNITION_OK left untouched
    so GPS stays on through arm→immobilize theft-tracking sequence.
    - handleAlert() turns GPS on if still off (boot-armed edge case).
    - updateGPS() early-returns when GPS is off — no AT error spam,
    last-known lat/lon preserved, speed cleared to unknown.
    - Motion state transitions now trigger an immediate sendStatusUpdate()
    to ntfy, cutting dashboard motion latency from ~45s to ~4-7s.
    [AntiTheftSystemLilygo.ino]
2026-06-24 fix(firmware): C1 IMG_BUF_SIZE mismatch, I2 boot state sync, I1 deferred STATUS
    - LILYGO: IMG_BUF_SIZE 51200 -> 65536 to match Main's 64KB buffer (C1)
    - Main: send STATUS:ARMED/DISARMED + IMMOBILIZED to LILYGO after boot
    handshake so GPS gating and poll cadence are correct from power-on (I2)
    - Main: statusPending flag defers STATUS sends blocked by alarmInProgress;
    flushed with correct armed/immobilized state after alarm completes (I1)
    All three fixes hardware-verified 2026-06-24.
    [AntiTheftSystemLilygo.ino, AntiTheftSystemMainESP.ino]
2026-07-02 Phase B cloud fixes: analyze auth+SSRF, lockout forwarding, per-dimension status timestamps
    worker.js:
    - I6: new "lockouts" cron category ("Immobilize refused" bodies) forwarded
    through the existing sendWhatsApp() + sendWebPushToAll(), deduped by
    msg:<id> like the other categories
    - I7: remove dead reply-filter clause -- "Command Reply" is an ntfy Title,
    never a body; the SMS_REPLY: check already catches all replies
    - B2: cron analyzePhoto() now passes CMD_SECRET as X-CMD-Secret to the
    Vercel analyze endpoint
    - B3: parseSystemStatus() returns per-dimension statusTs/ignitionTs (with
    legacy single-ts migration); cron status extraction writes per-dimension
    timestamps
    webapp:
    - api/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
2026-07-02 firmware: LILYGO armed-state fix + SMS dead-code strip; Main status-sync hardening
    - LILYGO: STATUS handler no longer clobbers systemArmed on IMMOBILIZED/IGNITION_OK;
    retired USE_NATIVE_SMS paths and OWNER_PHONE removed; header updated to MQTT/ntfy architecture
    - Main: RF arm/disarm defer STATUS on mutex-take failure; statusPending flushed from loop;
    LILYGO_READY handled in loop drain (late-boot state re-sync); alarm-task flush clears flag
    only on successful take; immobilized now volatile
    - CAM: line-ending normalization only, no content change
    Hardware-verified: boot NVS restore, dashboard + RF arm/disarm, armed IMMOBILIZE/RESTORE
    with armed state preserved, alert-with-photo, LILYGO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
    [AntiTheftSystemLilygo.ino, AntiTheftSystemMainESP.ino]
